Autonomous-OpenHD-OpenCV-RC-plane/Pi-Flight-Sensor-hat/KICAD PCB/rc-plane.kicad_pcb

## KiCad design KICAD PCB/rc-plane.kicad_pcb (2026-03-23)

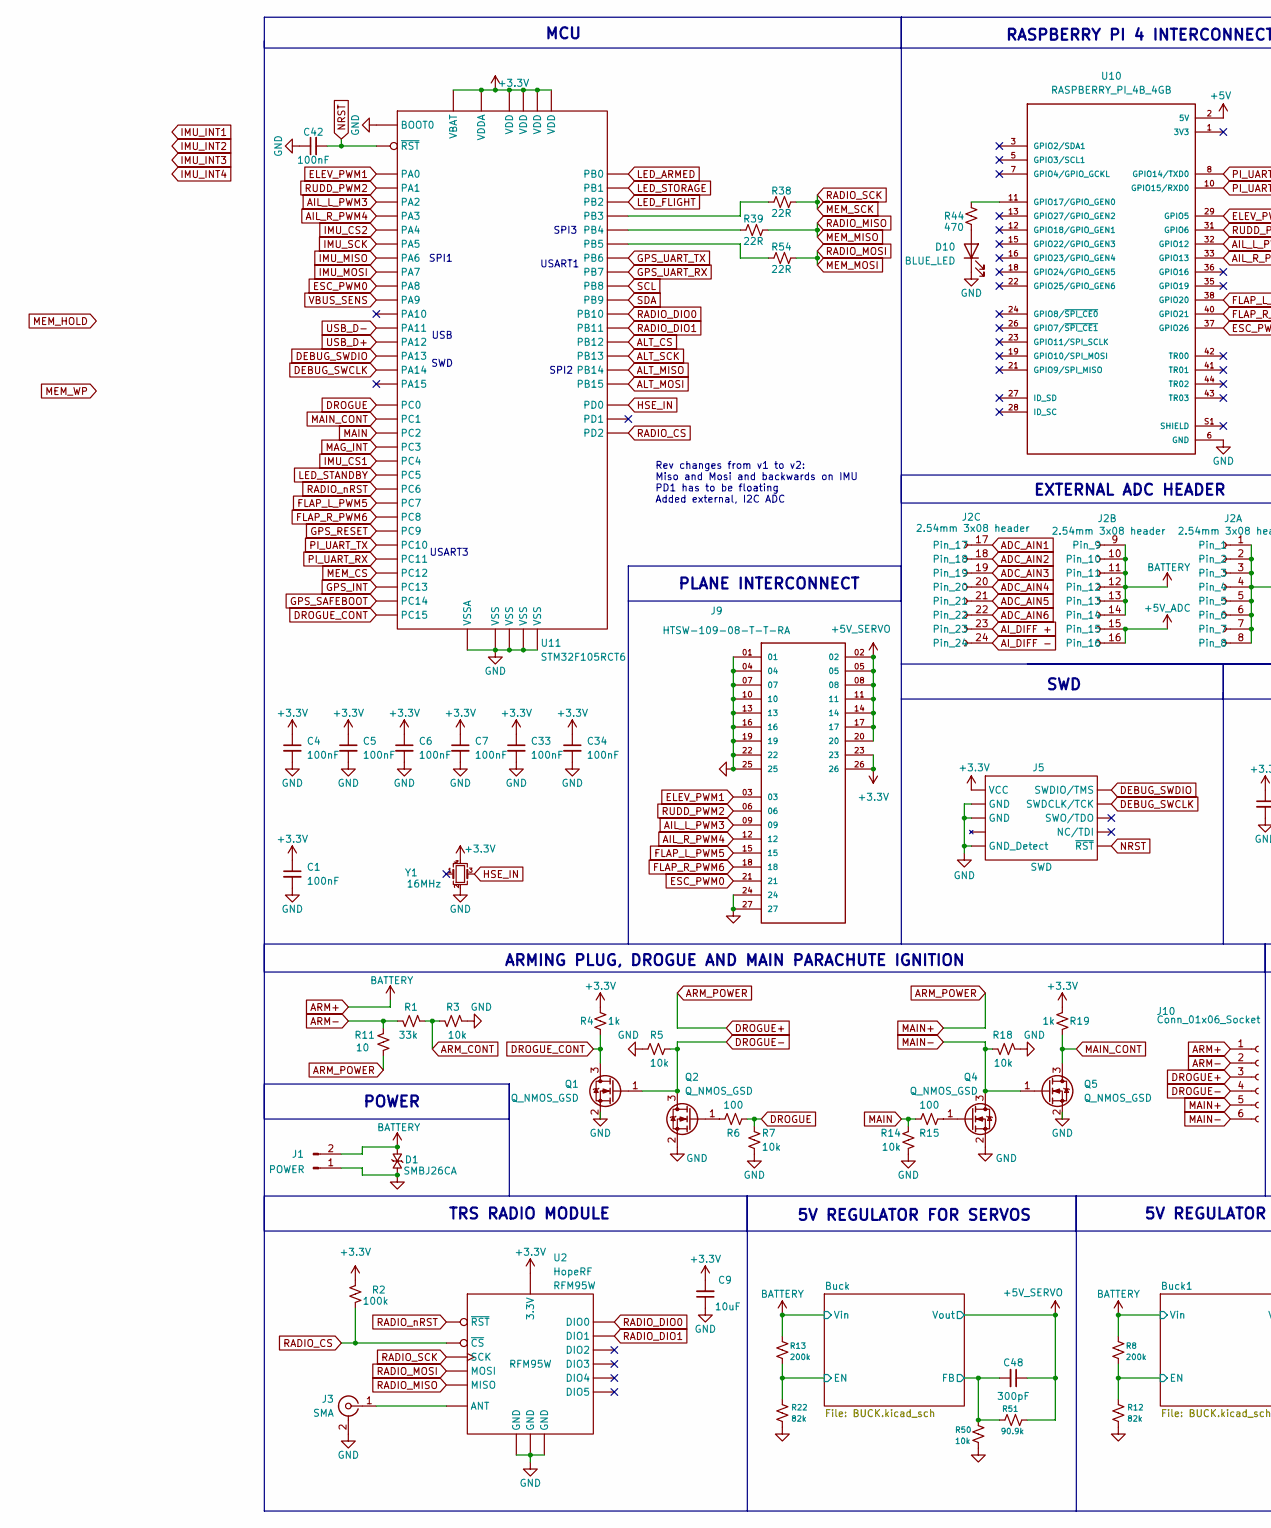
[picture p1: schematic rc-plane.kicad_sch, part in row 1, column 1]

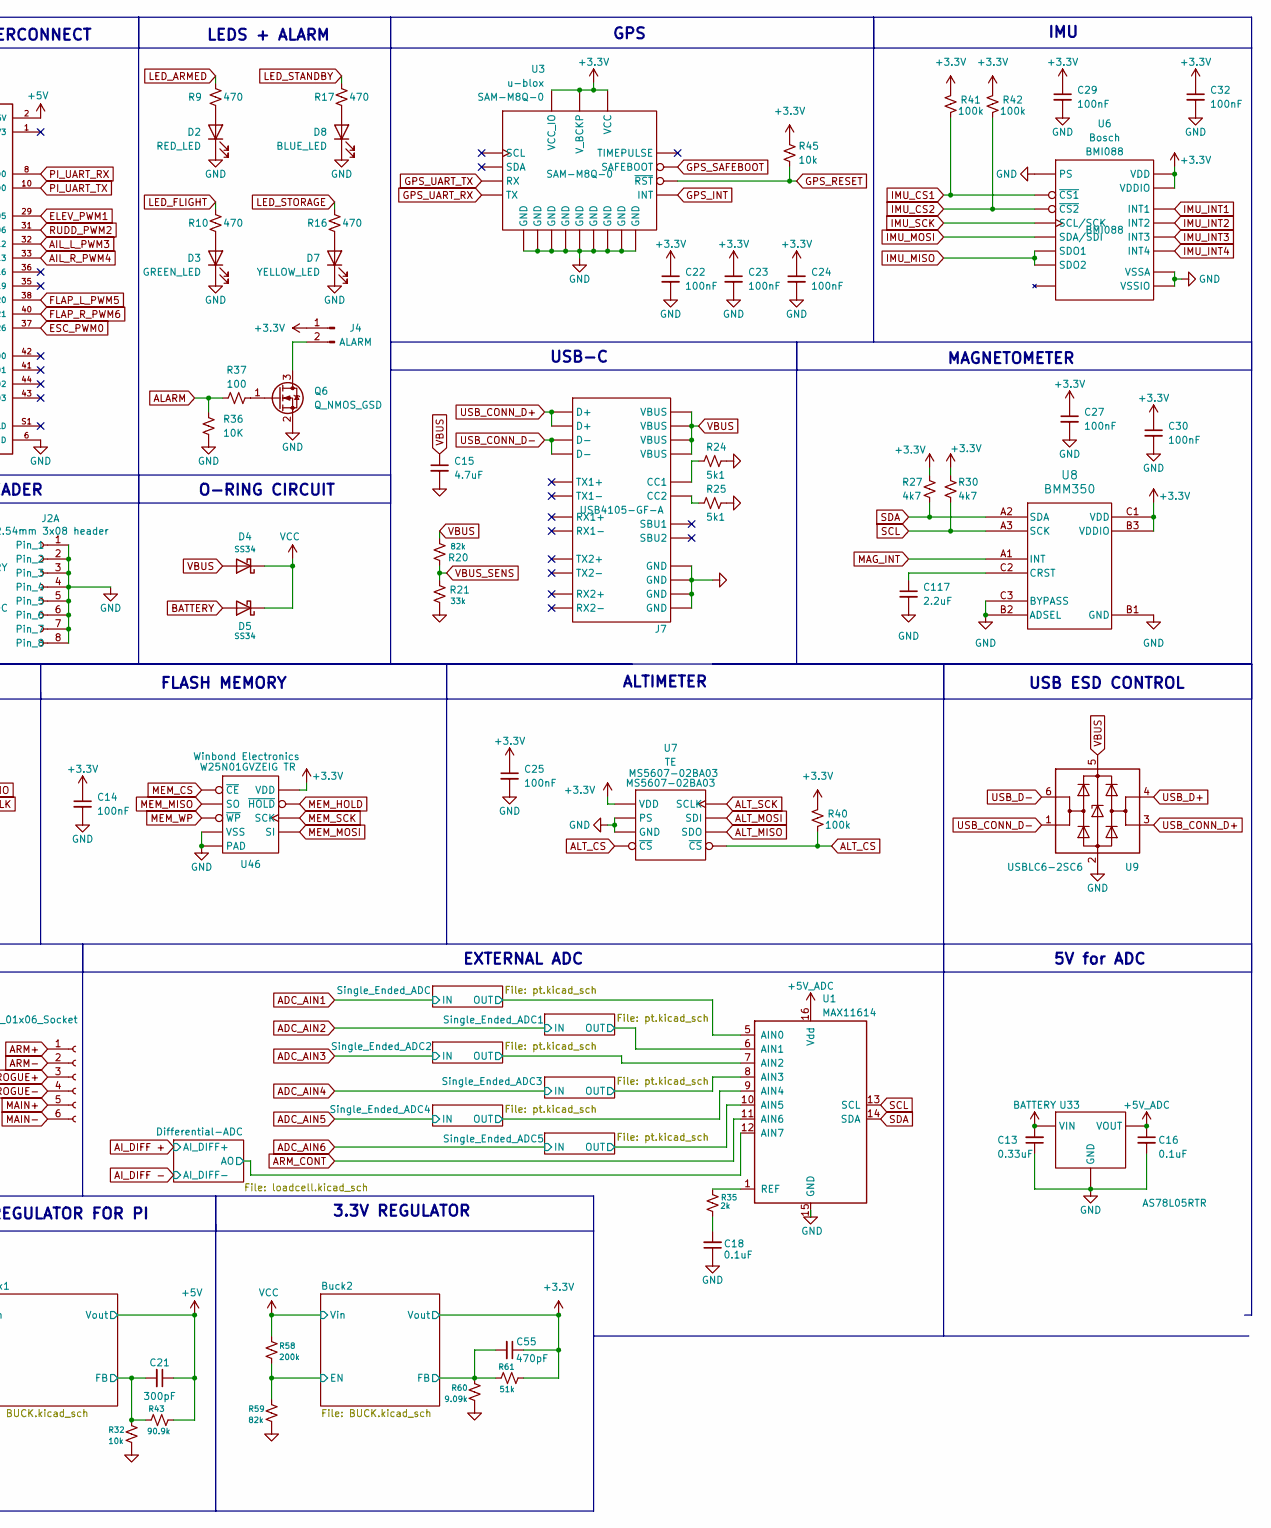
[picture p2: schematic rc-plane.kicad_sch, part in row 1, column 2]

Parts:
C1, C4, C5, C6, C7, C14, C22, C23, C24, C25, C29, C32, C33, C34, C42: 100nF; C_0603_1608Metric; Part # Generic 0603 6.3V 100nF X7R MLCC
C9: 10uF; C_0603_1608Metric; Part # Generic 0603 6.3V 100nF X7R MLCC
C13: 0.33uF; C_0603_1608Metric; Part # Generic 22uF 35V X5R 1206 MLCC
C15: 4.7uF; C_0603_1608Metric; Part # Generic 0603 6.3V 4.7uF X7R MLCC
C16, C18: 0.1uF; C_0603_1608Metric; Part # Generic 22uF 35V X5R 1206 MLCC
C21, C48: 300pF; C_0603_1608Metric; Part # Generic 0603 6.3V 100nF X7R MLCC
C27, C30: 100nF; C_0402_1005Metric; Part # Generic CAP CER 0.1UF 6.3V X7R 0402
C55: 470pF; C_0603_1608Metric; Part # Generic 0603 6.3V 100nF X7R MLCC
C117: 2.2uF; C_0402_1005Metric; Part # Generic CAP CER 0.1UF 6.3V X7R 0402
D1: SMBJ26CA; D_SMB; PARTREV I2102; DigiKey_Part_Number SMBJ26CAFSCT-ND
D2: RED_LED; D_0603_1608Metric; Part # Generic Green LED
D3: GREEN_LED; D_0603_1608Metric; Part # Generic Green LED
D4, D5: SS34; D_SMA; Part # SS34
D7: YELLOW_LED; D_0603_1608Metric; Part # Generic Yellow LED
D8, D10: BLUE_LED; D_0603_1608Metric; Part # Generic Green LED
J1: POWER; AMASS_XT60PW-M_1x02_P7.20mm_Horizontal; Part # XT60PW-F
J2: 2.54mm 3x08 header; HX PZ2.54-3x8P ZZ 3x08 2.54mm THT header; Part # HX PZ2.54-3x8P ZZ
J3: SMA; SMA_Molex_73251-2200_Horizontal; Part # 0732512200
J4: ALARM; XDCR_SMT-0540-S-R; Part # SMT-0540-S-R
J5: SWD; PinHeader_2x05_P1.27mm_Vertical_SMD; Part # X1321WVS-2x05J-C40D53
J7: USB4105-GF-A; USB_C_Receptacle_GCT_USB4105-xx-A_16P_TopMnt_Horizontal; Part # USB4105-GF-A
J9: HTSW-109-08-T-T-RA; SAMTEC_HTSW-109-08-T-T-RA; PARTREV R
J10: Conn_01x06_Socket; TerminalBlock_Xinya_XY308-2.54-6P_1x06_P2.54mm_Horizontal
Q1, Q2, Q4, Q5, Q6: Q_NMOS_GSD; TSOT-23; Part # WST3408
R1: 33k; R_0603_1608Metric; Part # Generic 0603 1k 1% Resistor
R2, R40, R41, R42: 100k; R_0603_1608Metric; Part # Generic 0603 1k 1% Resistor
R3: 10k; R_0603_1608Metric; Part # Generic 0603 3.3k 1% Resistor
R4, R19: 1k; R_0603_1608Metric; Part # Generic 0603 1k 1% Resistor
R5, R7, R14, R18: 10k; R_0603_1608Metric; Part # Generic 0603 10k 1% Resistor
R6, R15: 100; R_0603_1608Metric; Part # Generic 0603 100 1% Resistor
R8, R13, R58: 200k; R_0603_1608Metric
R9, R10, R16, R17, R44: 470; R_0603_1608Metric; Part # Generic 0603 470 1% Resistor
R11: 10; R_0603_1608Metric; Part # Generic 0603 1k 1% Resistor
R12, R22, R59: 82k; R_0603_1608Metric
R20: 82k; R_0603_1608Metric; Part # Generic 0603 33k 1% Resistor
R21: 33k; R_0603_1608Metric; Part # Generic 0603 82k 1% Resistor
R24, R25: 5k1; R_0603_1608Metric; Part # Generic 0603 5.1k 1% Resistor
R27, R30: 4k7; R_0402_1005Metric; Part # Generic RES SMD 4.7K OHM 1% 1/4W 0402
R32, R45, R50: 10k; R_0603_1608Metric
R35: 2k; R_0603_1608Metric
R36: 10K; R_0402_1005Metric; Part # Generic RES SMD 10K OHM 1% 1/4W 0402
R37: 100; R_0402_1005Metric; Part # Generic RES SMD 100 OHM 1% 1/4W 0402
R38, R39, R54: 22R; R_0402_1005Metric; Part # Generic RES SMD 4.7K OHM 1% 1/4W 0402
R43, R51: 90.9k; R_0603_1608Metric
R60: 9.09k; R_0603_1608Metric
R61: 51k; R_0603_1608Metric
U1: MAX11614; QSOP-16_3.9x4.9mm_P0.635mm
U2: RFM95W; Part # RFM95W
U3: SAM-M8Q-0; ublox_SAM-M8Q; Part # SAM-M8Q-0
U6: BMI088; Part # BMI088
U7: MS5607-02BA03; MS5607-02BA; Part # MS5607-02BA03
U8: BMM350; Part # BMM350
U9: USBLC6-2SC6; SOT-23-6; Part # USBLC6-2SC6
U10: RASPBERRY_PI_4B_4GB; MODULE_RASPBERRY_PI_4B_4GB; PARTREV 4
U11: STM32F105RCT6; LQFP-64_10x10mm_P0.5mm; Part # STM32F105RCT6
U33: AS78L05RTR; SOT-89-3
U46: W25N01GVZEIG TR; WSON-8-1EP_8x6mm_P1.27mm_EP3.4x4.3mm; Part # W25N01GVZEIG TR
Y1: 16MHz; Crystal_SMD_2520-4Pin_2.5x2.0mm; Part # ECS-1633-120-BN-TR

Connections:
+3.3V: C1.1, C4.1, C5.1, C6.1, C7.1, C9.2, C14.1, C22.1, C23.1, C24.1, C25.1, C27.1, C29.1, C30.1, C32.1, C33.1, C34.1, C55.1, J4.1, J5.1 (VCC), J9.23, J9.26, R2.2, R4.1, R19.1, R27.1, R30.1, R40.2, R41.2, R42.2, R45.1, R61.2, U2.13 (3.3V), U3.2 (VCC_IO), U3.3 (V_BCKP), U3.17 (VCC), U6.3 (VDD), U6.11 (VDDIO), U7.1 (VDD), U8.B3 (VDDIO), U8.C1 (VDD), U11.1 (VBAT), U11.13 (VDDA), U11.19 (VDD), U11.32 (VDD), U11.48 (VDD), U11.64 (VDD), U46.8 (VDD), Y1.4; also elsewhere on the board
+5V: C21.1, R43.2, U10.2 (5V), U10.4 (5V); also elsewhere on the board
+5V_ADC: C16.1, J2.15, J2.16, U1.16 (Vdd), U33.3 (VOUT); also elsewhere on the board
+5V_SERVO: C48.1, J9.02, J9.05, J9.08, J9.11, J9.14, J9.17, J9.20, R51.2; also elsewhere on the board
/Buck1/EN: R8.2, R12.1; also elsewhere on the board
/Buck1/FB: C21.2, R32.1, R43.1; also elsewhere on the board
/Buck2/EN: R58.2, R59.1; also elsewhere on the board
/Buck2/FB: C55.2, R60.1, R61.1; also elsewhere on the board
/Buck/EN: R13.2, R22.1; also elsewhere on the board
/Buck/FB: C48.2, R50.1, R51.1; also elsewhere on the board
/Differential-ADC/AO: U1.12 (AIN7); also elsewhere on the board
/Single_Ended_ADC1/OUT: U1.6 (AIN1); also elsewhere on the board
/Single_Ended_ADC2/OUT: U1.7 (AIN2); also elsewhere on the board
/Single_Ended_ADC3/OUT: U1.8 (AIN3); also elsewhere on the board
/Single_Ended_ADC4/OUT: U1.9 (AIN4); also elsewhere on the board
/Single_Ended_ADC5/OUT: U1.10 (AIN5); also elsewhere on the board
/Single_Ended_ADC/OUT: U1.5 (AIN0); also elsewhere on the board
ADC_AIN1: J2.17; also elsewhere on the board
ADC_AIN2: J2.18; also elsewhere on the board
ADC_AIN3: J2.19; also elsewhere on the board
ADC_AIN4: J2.20; also elsewhere on the board
ADC_AIN5: J2.21; also elsewhere on the board
ADC_AIN6: J2.22; also elsewhere on the board
AIL_L_PWM3: J9.09, U10.32 (GPIO12), U11.16 (PA2)
AIL_R_PWM4: J9.12, U10.33 (GPIO13), U11.17 (PA3)
AI_DIFF +: J2.23; also elsewhere on the board
AI_DIFF -: J2.24; also elsewhere on the board
ALARM: R36.2, R37.1
ALT_CS: R40.1, U7.4 (~CS), U7.5 (~CS), U11.33 (PB12)
ALT_MISO: U7.6 (SDO), U11.35 (PB14)
ALT_MOSI: U7.7 (SDI), U11.36 (PB15)
ALT_SCK: U7.8 (SCLK), U11.34 (PB13)
ARM+: C13.2, D1.1, D5.2 (A), J1.2, J2.9, J2.10, J2.11, J2.12, J2.13, J2.14, J10.1, R8.1, R13.1, U33.1 (VIN); also elsewhere on the board
ARM-: J10.2, R1.1, R11.2
ARM_CONT: R1.2, R3.1, U1.11 (AIN6)
ARM_POWER: J10.3, J10.5, R11.1
DEBUG_SWCLK: J5.4 (SWDCLK/TCK), U11.49 (PA14)
DEBUG_SWDIO: J5.2 (SWDIO/TMS), U11.46 (PA13)
DROGUE: R6.2, R7.1, U11.8 (PC0)
DROGUE-: J10.4, Q1.1 (G), Q2.3 (D), R5.1
DROGUE_CONT: Q1.3 (D), R4.2, U11.4 (PC15)
ELEV_PWM1: J9.03, U10.29 (GPIO5), U11.14 (PA0)
ESC_PWM0: J9.21, U10.37 (GPIO26), U11.41 (PA8)
FLAP_L_PWM5: J9.15, U10.38 (GPIO20), U11.38 (PC7)
FLAP_R_PWM6: J9.18, U10.40 (GPIO21), U11.39 (PC8)
GND: C1.2, C4.2, C5.2, C6.2, C7.2, C9.1, C13.1, C14.2, C15.2, C16.2, C18.1, C22.2, C23.2, C24.2, C25.2, C27.2, C29.2, C30.2, C32.2, C33.2, C34.2, C42.1, C117.2, D1.2, D2.1 (K), D3.1 (K), D7.1 (K), D8.1 (K), D10.1 (K), J1.1, J2.1, J2.2, J2.3, J2.4, J2.5, J2.6, J2.7, J2.8, J3.2 (Ext), J5.3 (GND), J5.5 (GND), J5.9 (GND_Detect), J7.A1 (GND), J7.A12 (GND), J7.B1 (GND), J7.B12 (GND), J9.01, J9.04, J9.07, J9.10, J9.13, J9.16, J9.19, J9.22, J9.24, J9.25, J9.27, Q1.2 (S), Q2.2 (S), Q4.2 (S), Q5.2 (S), Q6.2 (S), R3.2, R5.2, R7.2, R12.2, R14.2, R18.2, R21.1, R22.2, R24.1, R25.1, R32.2, R36.1, R50.2, R59.2, R60.2, U1.15 (GND), U2.1 (GND), U2.8 (GND), U2.10 (GND), U3.1 (GND), U3.4 (GND), U3.5 (GND), U3.6 (GND), U3.10 (GND), U3.11 (GND), U3.15 (GND), U3.16 (GND), U3.20 (GND), U6.4 (VSSA), U6.6 (VSSIO), U6.7 (PS), U7.2 (PS), U7.3 (GND), U8.B1 (GND), U8.B2 (ADSEL), U8.C3 (BYPASS), U9.2 (GND), U10.6 (GND), U10.9 (GND), U10.14 (GND), U10.20 (GND), U10.25 (GND), U10.30 (GND), U10.34 (GND), U10.39 (GND), U11.12 (VSSA), U11.18 (VSS), U11.31 (VSS), U11.47 (VSS), U11.60 (BOOT0), U11.63 (VSS), U33.2 (GND), U46.4 (VSS), U46.9 (PAD), Y1.2; also elsewhere on the board
GPS_INT: U3.19 (INT), U11.2 (PC13)
GPS_RESET: R45.2, U3.18 (~RST), U11.40 (PC9)
GPS_SAFEBOOT: U3.8 (SAFEBOOT), U11.3 (PC14)
GPS_UART_RX: U3.13 (TX), U11.59 (PB7)
GPS_UART_TX: U3.14 (RX), U11.58 (PB6)
HSE_IN: U11.5 (PD0), Y1.3
IMU_CS1: R41.1, U6.14 (~CS1), U11.24 (PC4)
IMU_CS2: R42.1, U6.5 (~CS2), U11.20 (PA4)
IMU_INT1: U6.16 (INT1)
IMU_INT2: U6.1 (INT2)
IMU_INT3: U6.12 (INT3)
IMU_INT4: U6.13 (INT4)
IMU_MISO: U6.10 (SDO2), U6.15 (SDO1), U11.22 (PA6)
IMU_MOSI: U6.9 (SDA/SDI), U11.23 (PA7)
IMU_SCK: U6.8 (SCL/SCK), U11.21 (PA5)
LED_ARMED: R9.1, U11.26 (PB0)
LED_FLIGHT: R10.1, U11.28 (PB2)
LED_STANDBY: R17.1, U11.25 (PC5)
LED_STORAGE: R16.1, U11.27 (PB1)
MAG_INT: U8.A1 (INT), U11.11 (PC3)
MAIN: R14.1, R15.1, U11.10 (PC2)
MAIN-: J10.6, Q4.3 (D), Q5.1 (G), R18.1
MAIN_CONT: Q5.3 (D), R19.2, U11.9 (PC1)
MEM_CS: U11.53 (PC12), U46.1 (~CE)
MEM_HOLD: U46.7 (~HOLD)
MEM_MISO: R39.2, U2.2 (MISO), U46.2 (SO)
MEM_MOSI: R54.2, U2.3 (MOSI), U46.5 (SI)
MEM_SCK: R38.2, U2.4 (SCK), U46.6 (SCK)
MEM_WP: U46.3 (~WP)
NRST: C42.2, J5.10 (~RST), U11.7 (~RST)
unnamed: C18.2, R35.1
unnamed: D2.2 (A), R9.2
unnamed: D3.2 (A), R10.2
unnamed: D7.2 (A), R16.2
unnamed: D8.2 (A), R17.2
unnamed: D10.2 (A), R44.2
unnamed: J3.1 (In), U2.9 (ANT)
unnamed: J4.2, Q6.3 (D)
unnamed: J7.A5 (CC1), R24.2
unnamed: J7.B5 (CC2), R25.2
unnamed: Q2.1 (G), R6.1
unnamed: Q4.1 (G), R15.2
unnamed: Q6.1 (G), R37.2
unnamed: R35.2, U1.1 (REF)
unnamed: C117.1, U8.C2 (CRST)
unnamed: R44.1, U10.11 (GPIO17/GPIO_GEN0)
unnamed: R38.1, U11.55 (PB3)
unnamed: R39.1, U11.56 (PB4)
unnamed: R54.1, U11.57 (PB5)
PI_UART_RX: U10.8 (GPIO14/TXD0), U11.52 (PC11)
PI_UART_TX: U10.10 (GPIO15/RXD0), U11.51 (PC10)
RADIO_CS: R2.1, U2.5 (~CS), U11.54 (PD2)
RADIO_DIO0: U2.14 (DIO0), U11.29 (PB10)
RADIO_DIO1: U2.15 (DIO1), U11.30 (PB11)
RADIO_nRST: U2.6 (~RST), U11.37 (PC6)
RUDD_PWM2: J9.06, U10.31 (GPIO6), U11.15 (PA1)
SCL: R30.2, U1.13 (SCL), U8.A3 (SCK), U11.61 (PB8)
SDA: R27.2, U1.14 (SDA), U8.A2 (SDA), U11.62 (PB9)
USB_CONN_D+: J7.A6 (D+), J7.B6 (D+), U9.3 (I/O2)
USB_CONN_D-: J7.A7 (D-), J7.B7 (D-), U9.1 (I/O1)
USB_D+: U9.4 (I/O2), U11.45 (PA12)
USB_D-: U9.6 (I/O1), U11.44 (PA11)
VBUS: C15.1, D4.2 (A), J7.A4 (VBUS), J7.A9 (VBUS), J7.B4 (VBUS), J7.B9 (VBUS), R20.1, U9.5 (VBUS)
VBUS_SENS: R20.2, R21.2, U11.42 (PA9)
VCC: D4.1 (K), D5.1 (K), R58.1; also elsewhere on the board

Notes on the sheet:
USART1
POWER
TRS RADIO MODULE
PLANE INTERCONNECT
USB ESD CONTROL
Rev changes from v1 to v2: Miso and Mosi and backwards on IMU PD1 has to be floating Added external, I2C ADC
USART3
5V for ADC
SWD
MCU
ALTIMETER
5V REGULATOR FOR SERVOS
SPI2
SWD
O-RING CIRCUIT
GPS
IMU
EXTERNAL ADC HEADER
MAGNETOMETER
FLASH MEMORY
RASPBERRY PI 4 INTERCONNECT
SPI1
USB-C
USB
LEDS + ALARM
ARMING PLUG, DROGUE AND MAIN PARACHUTE IGNITION
5V REGULATOR FOR PI
SPI3
EXTERNAL ADC
3.3V REGULATOR

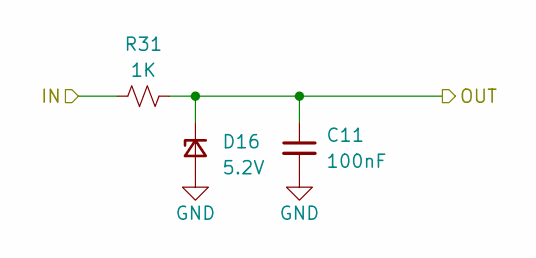
[picture p3: schematic pt.kicad_sch]

Parts:
C11: 100nF; C_0402_1005Metric; Part # Generic CAP CER 0.1UF 6.3V X7R 0402
D16: 5.2V; D_SOD-882; Part # BZT52C3V9LP-7
R31: 1K; R_0402_1005Metric; Part # Generic RES SMD 1K OHM 1% 1/16W 0402

Connections:
/Single_Ended_ADC/OUT: C11.1, D16.1 (K), R31.2; also elsewhere on the board
ADC_AIN1: R31.1; also elsewhere on the board
GND: C11.2, D16.2 (A); also elsewhere on the board

Parts of its further copies:
C2, C3, C8, C10, C12: 100nF; C_0402_1005Metric; Part # Generic CAP CER 0.1UF 6.3V X7R 0402
R23, R26, R28, R29, R33: 1K; R_0402_1005Metric; Part # Generic RES SMD 1K OHM 1% 1/16W 0402

Connections of its further copies:
/Single_Ended_ADC1/OUT: C2.1, R23.2; also elsewhere on the board
/Single_Ended_ADC2/OUT: C3.1, R26.2; also elsewhere on the board
/Single_Ended_ADC3/OUT: C8.1, R28.2; also elsewhere on the board
/Single_Ended_ADC4/OUT: C10.1, R29.2; also elsewhere on the board
/Single_Ended_ADC5/OUT: C12.1, R33.2; also elsewhere on the board
ADC_AIN2: R23.1; also elsewhere on the board
ADC_AIN3: R26.1; also elsewhere on the board
ADC_AIN4: R28.1; also elsewhere on the board
ADC_AIN5: R29.1; also elsewhere on the board
ADC_AIN6: R33.1; also elsewhere on the board
GND: C2.2, C3.2, C8.2, C10.2, C12.2; also elsewhere on the board

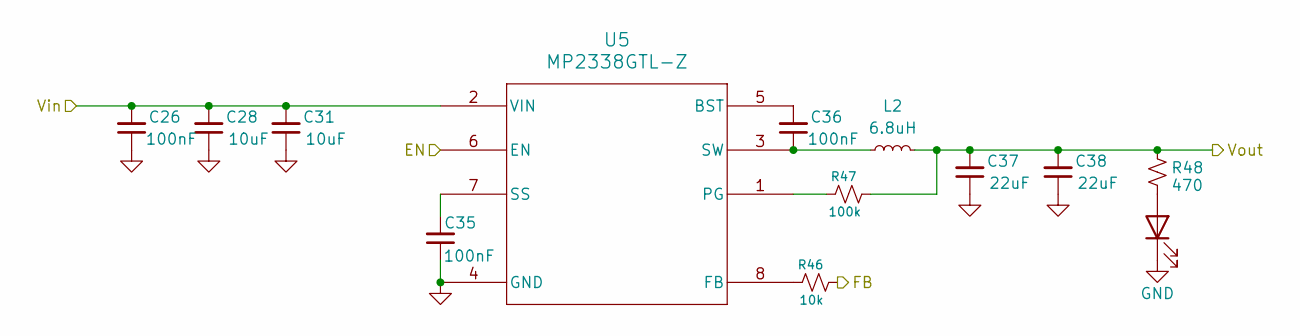
[picture p4: schematic BUCK.kicad_sch]

Parts:
C26, C35, C36: 100nF; C_0603_1608Metric; Part # Generic 0603 6.3V 100nF X7R MLCC
C28, C31: 10uF; C_0603_1608Metric; Part # Generic 0603 6.3V 100nF X7R MLCC
C37, C38: 22uF; C_0603_1608Metric; Part # Generic 0603 6.3V 100nF X7R MLCC
D11: BLUE_LED; D_0603_1608Metric; Part # Generic Green LED
L2: 6.8uH; IND_VLS6045EX-6R8M; Part # VLS6045EX-6R8M
R46: 10k; R_0603_1608Metric
R47: 100k; R_0603_1608Metric
R48: 470; R_0603_1608Metric; Part # Generic 0603 470 1% Resistor
U5: MP2338GTL-Z; SOT583_MP2338_MNP; Part # MP2338GTL-P

Connections:
+5V: C37.2, C38.2, L2.2, R47.2, R48.1; also elsewhere on the board
/Buck1/EN: U5.6 (EN); also elsewhere on the board
/Buck1/FB: R46.2; also elsewhere on the board
ARM+: C26.2, C28.2, C31.2, U5.2 (VIN); also elsewhere on the board
GND: C26.1, C28.1, C31.1, C35.1, C37.1, C38.1, D11.1 (K), U5.4 (GND); also elsewhere on the board
unnamed: D11.2 (A), R48.2
unnamed: C36.2, U5.5 (BST)
unnamed: R46.1, U5.8 (FB)
unnamed: R47.1, U5.1 (PG)
unnamed: C35.2, U5.7 (SS)
unnamed: C36.1, L2.1, U5.3 (SW)

Parts of its further copies:
C39, C43, C44, C46, C51, C52: 100nF; C_0603_1608Metric; Part # Generic 0603 6.3V 100nF X7R MLCC
C40, C41, C49, C50: 10uF; C_0603_1608Metric; Part # Generic 0603 6.3V 100nF X7R MLCC
C45, C47, C53, C54: 22uF; C_0603_1608Metric; Part # Generic 0603 6.3V 100nF X7R MLCC
D12, D13: BLUE_LED; D_0603_1608Metric; Part # Generic Green LED
L3, L4: 6.8uH; IND_VLS6045EX-6R8M; Part # VLS6045EX-6R8M
R49, R53: 10k; R_0603_1608Metric
R52, R55: 100k; R_0603_1608Metric
R56, R57: 470; R_0603_1608Metric; Part # Generic 0603 470 1% Resistor
U12, U13: MP2338GTL-Z; SOT583_MP2338_MNP; Part # MP2338GTL-P

Connections of its further copies:
+3.3V: C53.2, C54.2, L4.2, R55.2, R57.1; also elsewhere on the board
+5V_SERVO: C45.2, C47.2, L3.2, R52.2, R56.1; also elsewhere on the board
/Buck2/EN: U13.6 (EN); also elsewhere on the board
/Buck2/FB: R49.2; also elsewhere on the board
/Buck/EN: U12.6 (EN); also elsewhere on the board
/Buck/FB: R53.2; also elsewhere on the board
ARM+: C39.2, C40.2, C41.2, U12.2 (VIN); also elsewhere on the board
GND: C39.1, C40.1, C41.1, C43.1, C45.1, C46.1, C47.1, C49.1, C50.1, C51.1, C53.1, C54.1, D12.1 (K), D13.1 (K), U12.4 (GND), U13.4 (GND); also elsewhere on the board
unnamed: D12.2 (A), R56.2
unnamed: D13.2 (A), R57.2
unnamed: C44.2, U12.5 (BST)
unnamed: R53.1, U12.8 (FB)
unnamed: R52.1, U12.1 (PG)
unnamed: C43.2, U12.7 (SS)
unnamed: C44.1, L3.1, U12.3 (SW)
unnamed: C52.2, U13.5 (BST)
unnamed: R49.1, U13.8 (FB)
unnamed: R55.1, U13.1 (PG)
unnamed: C51.2, U13.7 (SS)
unnamed: C52.1, L4.1, U13.3 (SW)
VCC: C46.2, C49.2, C50.2, U13.2 (VIN); also elsewhere on the board

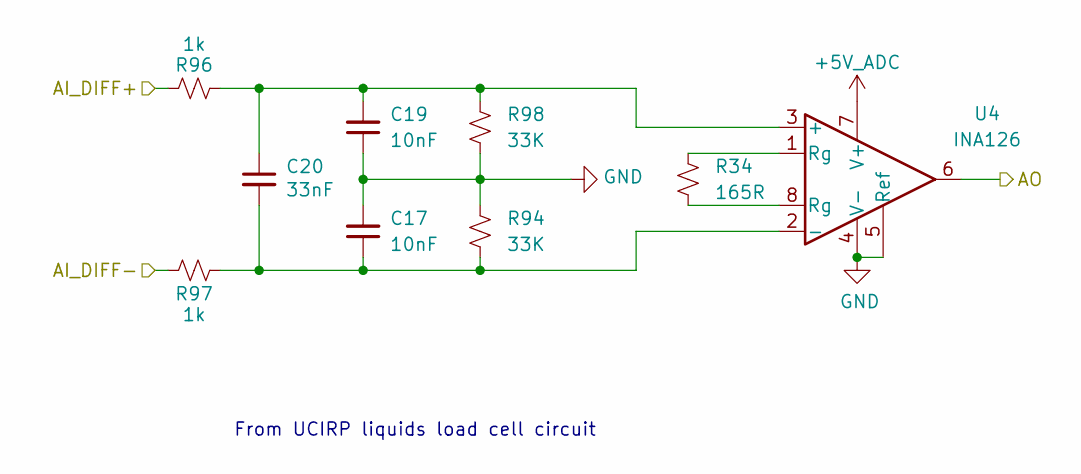
[picture p5: schematic loadcell.kicad_sch]

Parts:
C17, C19: 10nF; C_0603_1608Metric
C20: 33nF; C_0603_1608Metric
R34: 165R; R_0603_1608Metric; Part # Generic 33K 1% 0402 Resistor
R94, R98: 33K; R_0603_1608Metric; Part # Generic 33K 1% 0402 Resistor
R96, R97: 1k; R_0603_1608Metric
U4: INA126; SOIC-8_3.9x4.9mm_P1.27mm

Connections:
+5V_ADC: U4.7 (V+); also elsewhere on the board
/Differential-ADC/AO: U4.6; also elsewhere on the board
AI_DIFF +: R96.2; also elsewhere on the board
AI_DIFF -: R97.1; also elsewhere on the board
GND: C17.2, C19.1, R94.2, R98.1, U4.4 (V-), U4.5 (Ref); also elsewhere on the board
unnamed: R34.1, U4.8 (Rg)
unnamed: R34.2, U4.1 (Rg)
unnamed: C19.2, C20.1, R96.1, R98.2, U4.3 (+)
unnamed: C17.1, C20.2, R94.1, R97.2, U4.2 (-)

Notes on the sheet:
From UCIRP liquids load cell circuit

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
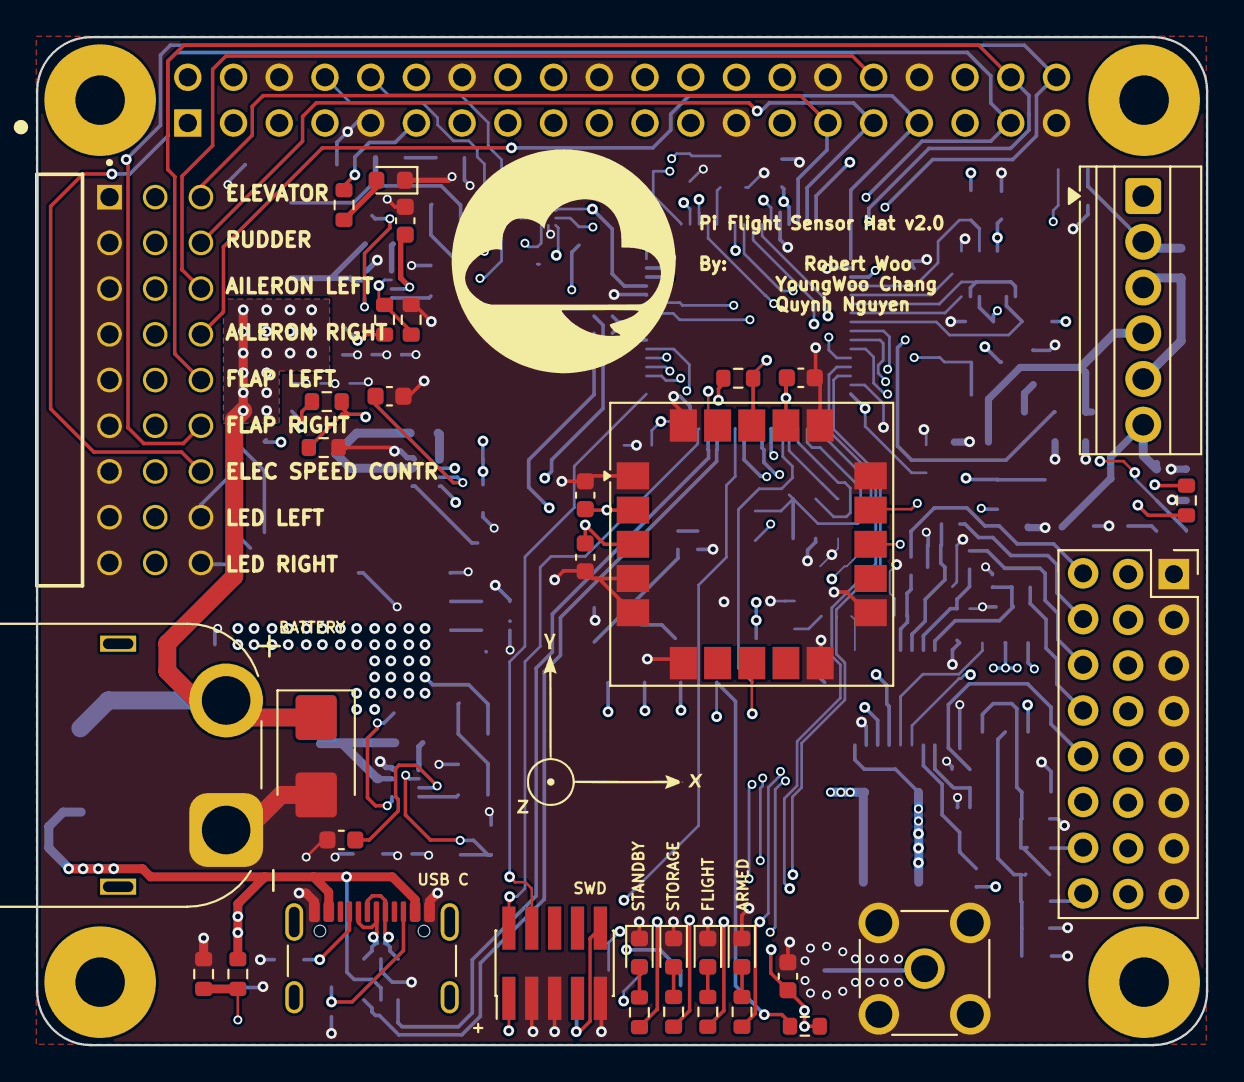
[picture p6: board rc-plane.kicad_pcb from above]

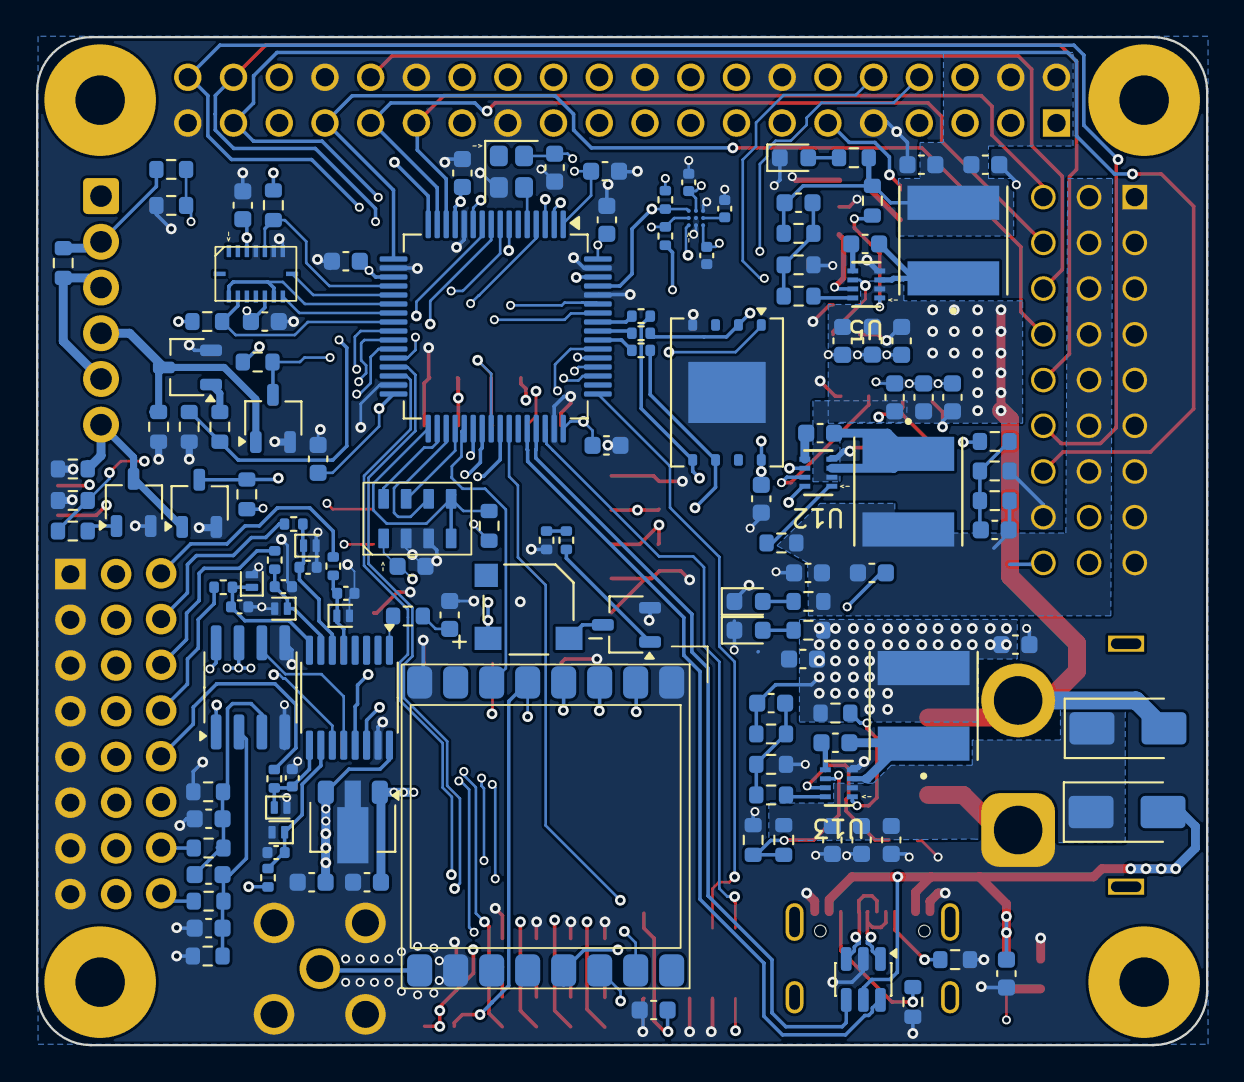
[picture p7: board rc-plane.kicad_pcb from below]

Board: 4 copper layers, 65.0 x 56.0 mm, 170 parts (134 on the bottom side), 127 nets.

Other parts of the board:
D6, D9, D14, D15, D17: 3.9V; D_SOD-882

Their connections:
/Single_Ended_ADC1/OUT: D6.1 (K); also elsewhere on the board
/Single_Ended_ADC2/OUT: D9.1 (K); also elsewhere on the board
/Single_Ended_ADC3/OUT: D14.1 (K); also elsewhere on the board
/Single_Ended_ADC4/OUT: D15.1 (K); also elsewhere on the board
/Single_Ended_ADC5/OUT: D17.1 (K); also elsewhere on the board
GND: D6.2 (A), D9.2 (A), D14.2 (A), D15.2 (A), D17.2 (A); also elsewhere on the board
