Autonomous-OpenHD-OpenCV-RC-plane/Pi-Flight-Sensor-hat/Hat-firmware/src/main.c

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
/* Includes ------------------------------------------------------------------*/
#include "main.h"
#include "usb_device.h"

ADC_HandleTypeDef hadc1;

I2C_HandleTypeDef hi2c1;

SPI_HandleTypeDef hspi1;
SPI_HandleTypeDef hspi2;
SPI_HandleTypeDef hspi3;

TIM_HandleTypeDef htim1;
TIM_HandleTypeDef htim2;
TIM_HandleTypeDef htim3;

UART_HandleTypeDef huart1;
UART_HandleTypeDef huart3;

void SystemClock_Config(void);
static void MX_GPIO_Init(void);
static void MX_ADC1_Init(void);
static void MX_I2C1_Init(void);
static void MX_SPI1_Init(void);
static void MX_SPI2_Init(void);
static void MX_SPI3_Init(void);
static void MX_TIM1_Init(void);
static void MX_TIM2_Init(void);
static void MX_TIM3_Init(void);
static void MX_USART1_UART_Init(void);
static void MX_USART3_UART_Init(void);
/**
  * @brief  The application entry point.
  * @retval int
  */
int main(void)
{

  /* USER CODE BEGIN 1 */
  MX_GPIO_Init();

  /* USER CODE END 1 */

  /* MCU Configuration--------------------------------------------------------*/

  /* Reset of all peripherals, Initializes the Flash interface and the Systick. */
  HAL_Init();

  /* Configure the system clock */
  SystemClock_Config();

  /* Initialize all configured peripherals */
  MX_GPIO_Init();
  MX_ADC1_Init();
  MX_I2C1_Init();
  MX_SPI1_Init();
  MX_SPI2_Init();
  MX_SPI3_Init();
  MX_TIM1_Init();
  MX_TIM2_Init();
  MX_TIM3_Init();
  MX_USART1_UART_Init();
  MX_USART3_UART_Init();
  // MX_USB_DEVICE_Init();

  /* USER CODE BEGIN 2 */
  uint8_t chipID = 0;
  uint8_t cmd_reset = 0xB6;
  uint8_t cmd_otp_disable = 0x80;
  uint16_t devAddr = (0x14); 
  HAL_StatusTypeDef ret;

  // 1. Perform a Soft Reset (Write 0xB6 to CMD register 0x7E)
  // This forces the state machine back to the top of your diagram
  HAL_I2C_Mem_Write(&hi2c1, devAddr, 0x7E, I2C_MEMADD_SIZE_8BIT, &cmd_reset, 1, 100);
  HAL_Delay(20); // Give it time to reboot

  // 2. Disable OTP access (Write 0x80 to OTP_CMD_REG 0x50)
  // This moves the chip from "OTP access granted" to "Suspend mode"
  HAL_I2C_Mem_Write(&hi2c1, devAddr, 0x50, I2C_MEMADD_SIZE_8BIT, &cmd_otp_disable, 1, 100);
  HAL_Delay(20);

  // 3. Now try reading the CHIP_ID (Register 0x00)
  ret = HAL_I2C_Mem_Read(&hi2c1, devAddr, 0x00, I2C_MEMADD_SIZE_8BIT, &chipID, 1, 100);

  if (ret == HAL_OK && chipID == 0x33) {
      HAL_GPIO_WritePin(LED_ARMED_GPIO_Port, LED_ARMED_Pin, GPIO_PIN_SET); // ID Correct!
  }
  /* USER CODE END 2 */


  /* Infinite loop */
  /* USER CODE BEGIN WHILE */
  while (1)
  {
    /* USER CODE END WHILE */
    HAL_GPIO_TogglePin(LED_STANDBY_GPIO_Port, LED_STANDBY_Pin);
    HAL_Delay(1000);
    /* USER CODE BEGIN 3 */
  }
  /* USER CODE END 3 */
}

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
