Autonomous-OpenHD-OpenCV-RC-plane/Pi-Flight-Sensor-hat/stm32_hat_firmware/stm32_hat_firmware.ioc

Mcu.UserName=STM32F105RCTx
PA0-WKUP.GPIO_Label=ELEV_PWM1
PA0-WKUP.Signal=S_TIM2_CH1_ETR
PA1.GPIO_Label=RUDD_PWM2
PA1.Signal=S_TIM2_CH2
PA11.Signal=USB_OTG_FS_DM
PA12.Signal=USB_OTG_FS_DP
PA13.Signal=SYS_JTMS-SWDIO
PA14.Signal=SYS_JTCK-SWCLK
PA2.GPIO_Label=AIL_L_PWM3
PA2.Signal=S_TIM2_CH3
PA3.GPIO_Label=AIL_R_PWM4
PA3.Signal=S_TIM2_CH4
PA4.GPIO_Label=IMU_CS2
PA4.Signal=GPIO_Output
PA5.GPIO_Label=IMU_SCK
PA5.Signal=SPI1_SCK
PA6.GPIO_Label=IMU_MISO
PA6.Signal=SPI1_MISO
PA7.GPIO_Label=IMUMOSI
PA7.Signal=SPI1_MOSI
PA8.GPIO_Label=ESC_PWM0
PA8.Signal=S_TIM1_CH1
PA9.Signal=USB_OTG_FS_VBUS
PB0.GPIO_Label=LED_ARMED
PB0.Signal=GPIO_Output
PB1.GPIO_Label=LED_STORAGE
PB1.Signal=GPIO_Output
PB10.GPIO_Label=EN_SERVO
PB10.Signal=GPIO_Output
PB11.GPIO_Label=EN_PI
PB11.Signal=GPIO_Output
PB12.GPIO_Label=ALT_CS
PB12.Signal=GPIO_Output
PB13.GPIO_Label=ALT_SCK
PB13.Signal=SPI2_SCK
PB14.GPIO_Label=ALT_MISO
PB14.Signal=SPI2_MISO
PB15.GPIO_Label=ALT_MOSI
PB15.Signal=SPI2_MOSI
PB2.GPIO_Label=LED_FLIGHT
PB2.Signal=GPIO_Output
PB3.GPIO_Label=SCK3
PB3.Signal=SPI3_SCK
PB4.GPIO_Label=MISO3
PB4.Signal=SPI3_MISO
PB5.GPIO_Label=MOSI3
PB5.Signal=SPI3_MOSI
PB6.GPIO_Label=GPS_UART_TX
PB6.Signal=USART1_TX
PB7.GPIO_Label=GPS_UART_RX
PB7.Signal=USART1_RX
PB8.GPIO_Label=SCL1
PB8.Signal=I2C1_SCL
PB9.GPIO_Label=SDA1
PB9.Signal=I2C1_SDA
PC0.GPIO_Label=DROGUE
PC0.Signal=GPIO_Output
PC1.GPIO_Label=MAIN_CONT
PC1.Signal=GPIO_Input
PC10.GPIO_Label=PI_UART_TX
PC10.Signal=USART3_TX
PC11.GPIO_Label=PI_UART_RX
PC11.Signal=USART3_RX
PC12.GPIO_Label=MEM_CS
PC12.Signal=GPIO_Output
PC13-TAMPER-RTC.GPIO_Label=GPS_INT
PC13-TAMPER-RTC.Signal=GPIO_Input
PC14-OSC32_IN.GPIO_Label=GPS_SAFEBOOT
PC14-OSC32_IN.Signal=GPIO_Output
PC15-OSC32_OUT.GPIO_Label=DROGUE_CONT
PC15-OSC32_OUT.Signal=GPIO_Input
PC2.GPIO_Label=MAIN
PC2.Signal=GPIO_Output
PC3.GPIO_Label=MAG_INT
PC3.Signal=GPIO_Input
PC4.GPIO_Label=IMU_CS1
PC4.Signal=GPIO_Output
PC5.GPIO_Label=LED_STANDBY
PC5.Signal=GPIO_Output
PC6.GPIO_Label=RADIO_NRST
PC6.Signal=GPIO_Output
PC7.GPIO_Label=FLAP_L_PWM5
PC7.Signal=S_TIM3_CH2
PC8.GPIO_Label=FLAP_R_PWM6
PC8.Signal=S_TIM3_CH3
PC9.GPIO_Label=GPS_RST
PC9.Signal=GPIO_Output
PD0-OSC_IN.Signal=RCC_OSC_IN
PD1-OSC_OUT.Signal=RCC_OSC_OUT
PD2.GPIO_Label=RADIO_CS
PD2.Signal=GPIO_Output
