Autonomous-OpenHD-OpenCV-RC-plane/Pi-Flight-Sensor-hat/stm32_hat_firmware/Core/Inc/main.h

#define GPS_INT_Pin GPIO_PIN_13
#define GPS_INT_GPIO_Port GPIOC
#define GPS_SAFEBOOT_Pin GPIO_PIN_14
#define GPS_SAFEBOOT_GPIO_Port GPIOC
#define DROGUE_CONT_Pin GPIO_PIN_15
#define DROGUE_CONT_GPIO_Port GPIOC
#define DROGUE_Pin GPIO_PIN_0
#define DROGUE_GPIO_Port GPIOC
#define MAIN_CONT_Pin GPIO_PIN_1
#define MAIN_CONT_GPIO_Port GPIOC
#define MAIN_Pin GPIO_PIN_2
#define MAIN_GPIO_Port GPIOC
#define MAG_INT_Pin GPIO_PIN_3
#define MAG_INT_GPIO_Port GPIOC
#define ELEV_PWM1_Pin GPIO_PIN_0
#define ELEV_PWM1_GPIO_Port GPIOA
#define RUDD_PWM2_Pin GPIO_PIN_1
#define RUDD_PWM2_GPIO_Port GPIOA
#define AIL_L_PWM3_Pin GPIO_PIN_2
#define AIL_L_PWM3_GPIO_Port GPIOA
#define AIL_R_PWM4_Pin GPIO_PIN_3
#define AIL_R_PWM4_GPIO_Port GPIOA
#define IMU_CS2_Pin GPIO_PIN_4
#define IMU_CS2_GPIO_Port GPIOA
#define IMU_SCK_Pin GPIO_PIN_5
#define IMU_SCK_GPIO_Port GPIOA
#define IMU_MISO_Pin GPIO_PIN_6
#define IMU_MISO_GPIO_Port GPIOA
#define IMUMOSI_Pin GPIO_PIN_7
#define IMUMOSI_GPIO_Port GPIOA
#define IMU_CS1_Pin GPIO_PIN_4
#define IMU_CS1_GPIO_Port GPIOC
#define LED_STANDBY_Pin GPIO_PIN_5
#define LED_STANDBY_GPIO_Port GPIOC
#define LED_ARMED_Pin GPIO_PIN_0
#define LED_ARMED_GPIO_Port GPIOB
#define LED_STORAGE_Pin GPIO_PIN_1
#define LED_STORAGE_GPIO_Port GPIOB
#define LED_FLIGHT_Pin GPIO_PIN_2
#define LED_FLIGHT_GPIO_Port GPIOB
#define EN_SERVO_Pin GPIO_PIN_10
#define EN_SERVO_GPIO_Port GPIOB
#define EN_PI_Pin GPIO_PIN_11
#define EN_PI_GPIO_Port GPIOB
#define ALT_CS_Pin GPIO_PIN_12
#define ALT_CS_GPIO_Port GPIOB
#define ALT_SCK_Pin GPIO_PIN_13
#define ALT_SCK_GPIO_Port GPIOB
#define ALT_MISO_Pin GPIO_PIN_14
#define ALT_MISO_GPIO_Port GPIOB
#define ALT_MOSI_Pin GPIO_PIN_15
#define ALT_MOSI_GPIO_Port GPIOB
#define RADIO_NRST_Pin GPIO_PIN_6
#define RADIO_NRST_GPIO_Port GPIOC
#define FLAP_L_PWM5_Pin GPIO_PIN_7
#define FLAP_L_PWM5_GPIO_Port GPIOC
#define FLAP_R_PWM6_Pin GPIO_PIN_8
#define FLAP_R_PWM6_GPIO_Port GPIOC
#define GPS_RST_Pin GPIO_PIN_9
#define GPS_RST_GPIO_Port GPIOC
#define ESC_PWM0_Pin GPIO_PIN_8
#define ESC_PWM0_GPIO_Port GPIOA
#define PI_UART_TX_Pin GPIO_PIN_10
#define PI_UART_TX_GPIO_Port GPIOC
#define PI_UART_RX_Pin GPIO_PIN_11
#define PI_UART_RX_GPIO_Port GPIOC
#define MEM_CS_Pin GPIO_PIN_12
#define MEM_CS_GPIO_Port GPIOC
#define RADIO_CS_Pin GPIO_PIN_2
#define RADIO_CS_GPIO_Port GPIOD
#define SCK3_Pin GPIO_PIN_3
#define SCK3_GPIO_Port GPIOB
#define MISO3_Pin GPIO_PIN_4
#define MISO3_GPIO_Port GPIOB
#define MOSI3_Pin GPIO_PIN_5
#define MOSI3_GPIO_Port GPIOB
#define GPS_UART_TX_Pin GPIO_PIN_6
#define GPS_UART_TX_GPIO_Port GPIOB
#define GPS_UART_RX_Pin GPIO_PIN_7
#define GPS_UART_RX_GPIO_Port GPIOB
#define SCL1_Pin GPIO_PIN_8
#define SCL1_GPIO_Port GPIOB
#define SDA1_Pin GPIO_PIN_9
#define SDA1_GPIO_Port GPIOB
