Autonomous-OpenHD-OpenCV-RC-plane/Pi-Flight-Sensor-hat/stm32_hat_firmware/Core/Inc/cpp_main.h

#ifndef CPP_MAIN_H
#define CPP_MAIN_H

#ifdef __cplusplus
extern "C" {
#endif

// The entry point for your C++ application
void cpp_main(void);

// Add other forwarding functions here if needed (e.g. error handlers, interrupt service routines)

#ifdef __cplusplus
}
#endif

#endif // CPP_MAIN_H
