Autonomous-OpenHD-OpenCV-RC-plane/Pi-Flight-Sensor-hat/(commit log)

2025-11-18 second commit
    [rc-plane.kicad_pcb, rc-plane.kicad_sch]
2025-11-18 Mostly done with schematic, need to do review
    [rc-plane.kicad_sch]
2025-11-28 made new bucks, only 4 warning/errors when importing from schematic
    [3V3_Buck.kicad_sch, 5V_BUCK.kicad_sch, BUCK.kicad_sch, rc-plane.kicad_pcb, rc-plane.kicad_sch, untitled.kicad_sch]
2025-11-28 layout mostly done
    [rc-plane.kicad_pcb]
2025-11-29 PCB done
    [rc-plane.kicad_pcb, rc-plane.kicad_sch]
2025-11-29 Added gerber, BOM, and parts list csv files for fab.
    [rc-plane-BOM.csv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]
2025-12-21 commit that was sent to jlcpcb
    [BUCK.kicad_sch, rc-plane-BOM.csv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]
2026-01-13 start firmware
    [3V3_Buck.kicad_sch, 5V_BUCK.kicad_sch, BUCK.kicad_sch, rc-plane.kicad_pcb, rc-plane.kicad_sch, untitled.kicad_sch]
2026-01-14 first commit for stm32 firmware
2026-01-23 Device ID working
2026-01-23 radio test good, need to add nrst to stm32
2026-02-01 working on rev2 on the board, deving out code for flight for stm32 software
    [bom.csv, designators.csv, loadcell.kicad_sch, positions.csv, pt.kicad_sch, rc-plane.kicad_pcb, rc-plane.kicad_sch]
2026-03-09 moved to stm32cube vscode extension, v2.0 purchased
    [positions.csv, pt.kicad_sch, rc-plane.kicad_pcb, rc-plane.kicad_sch]
2026-03-10 Move to stm32cubeide vscode extension. working
