Autonomous-OpenHD-OpenCV-RC-plane/Pi-Flight-Sensor-hat/(notices)

Notices in the files:
Hat-firmware/src/main.c:
Copyright (c) 2026 STMicroelectronics.
All rights reserved.
This software is licensed under terms that can be found in the LICENSE file
